DanielCreeklear/HEXPOD/README.md

# HEXPOD
Trabalho de Conclusão de Curso - Técnico em Mecatrônica - 1° Semestre, 2019.
ETEC Martin Luther King - Orientador: Professor Mestre Engenheiro Paulo Roberto Murguer Nogueira


> Status do Projeto: Concluido :heavy_check_mark:

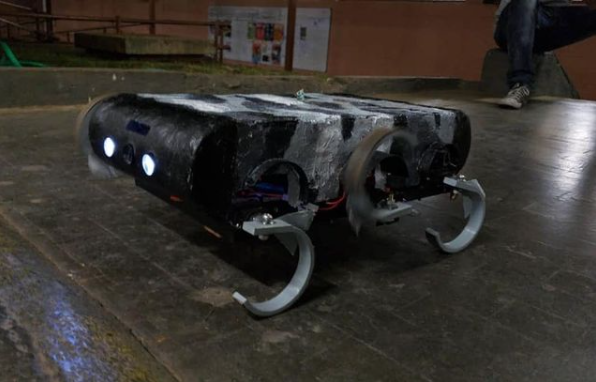
[picture p1: HEXPOD.png]
Foto do HEXPOD no seu ultimo dia de teste!


```C++ 
Serial.print("ESTOU VIVO!");
``` 
:laughing:
## Grupo
|[ <br> <sub> Allan Del Valle </sub>](https://www.linkedin.com/in/allan-del-valle-1b8012140/)|[ <br> <sub> Daniel Lopes </sub>](https://github.com/DanielCreeklear)|[ <br> <sub> Enrique Emanuel Rezende </sub>](https://github.com/Oiapokxui)|[ <br> <sub> Gabriel Luís Frutuoso </sub>](https://www.instagram.com/the_fruit_maker/) 	|
|:-:	|:-:	|:-:	|:-:	|
## Resumo
  Inspirado em um dos [robôs](https://www.youtube.com/watch?v=ISznqY3kESI) criados pela Boston Dynamics, o projeto se resume a um robô hexápode cujo propósito é ser remotamente controlado, útil em ambientes que inviabilizam o uso das rodas. Surge da necessidade de um robô que percorresse a maioria dos terrenos sem muitas dificuldades. Para isso, constitui-se de seis patas com o formato ‘C’, que garante uma boa mobilidade. Com controle por rádio frequência, também inclui uma câmera sem fio, que permite monitoramento a distância e auxilia o controle dos movimentos executados pelo  robô.
## Equipamentos do robô :checkered_flag:

:trophy: Câmera FPV por radio frequência 

:trophy: Controle com 4 botões e 1 analógico via Rádio Frequência

:trophy: Sensor Ultrassônico para navegação autônoma
## Linguagens e bibliotecas utilizadas :books:

- [C/C++ (Arduino)](https://www.arduino.cc/)
- VirtualWire 1.27
## Diagramas e desenhos :page_with_curl:
