DanielCreeklear/HEXPOD/DiagramaMotor.png

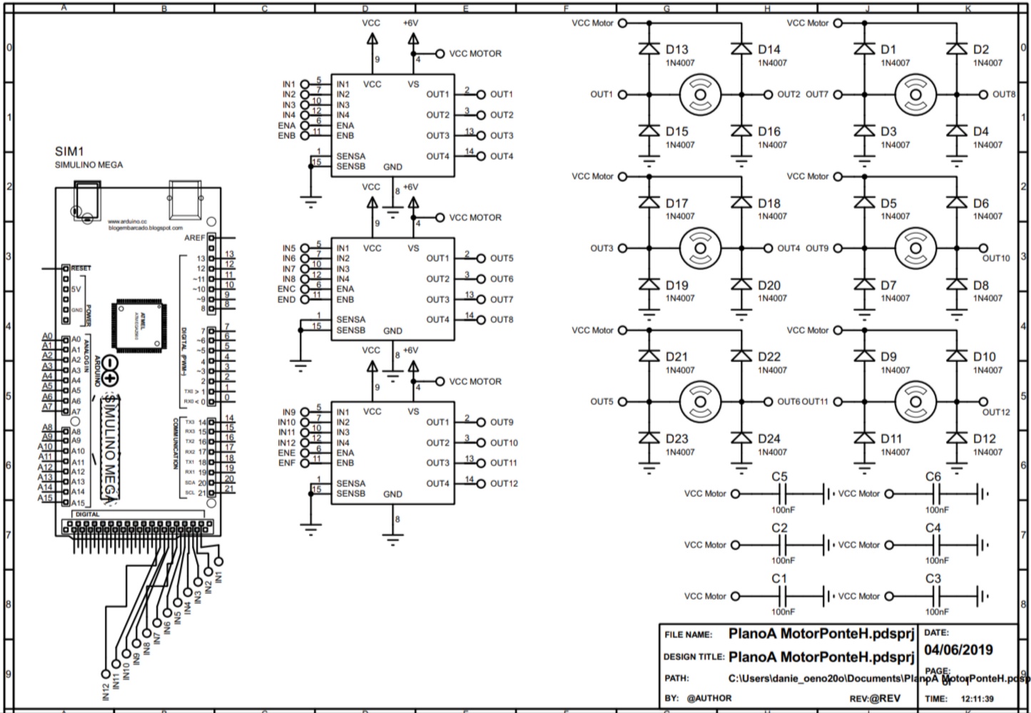
DiagramaMotor.png
