DanielCreeklear/HEXPOD/Mapeamento controle.jpg

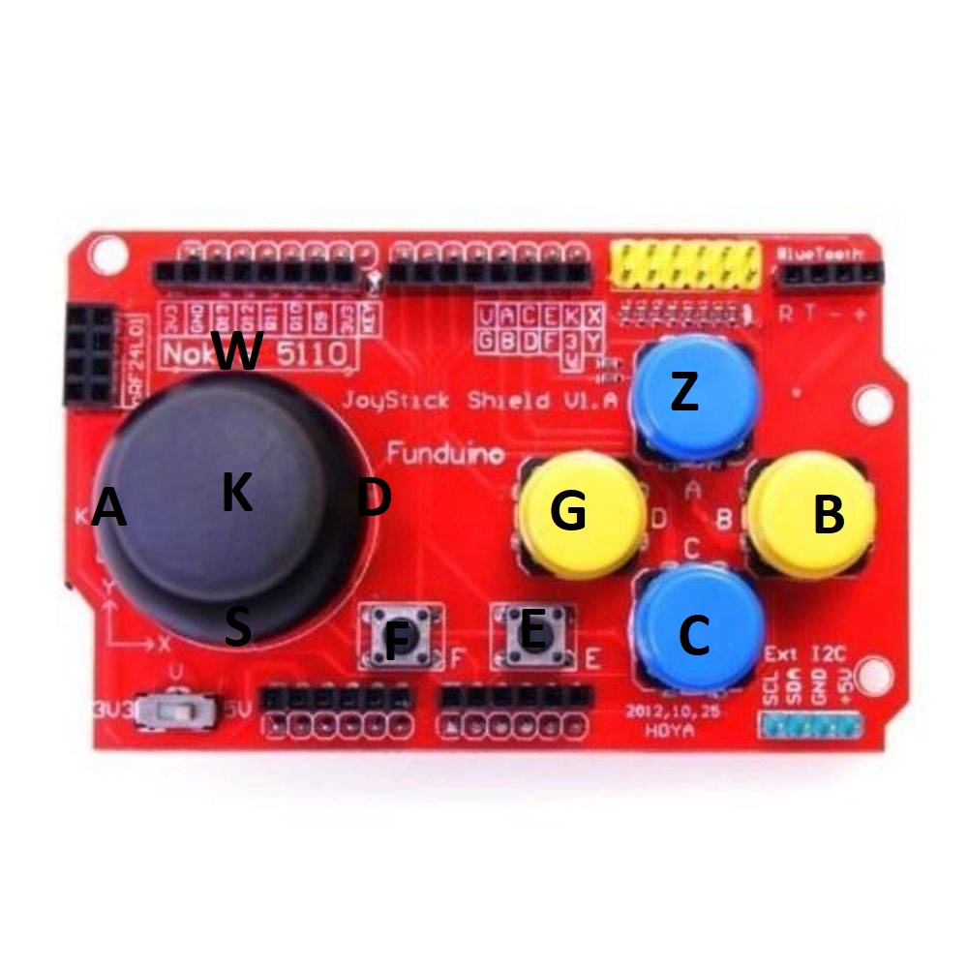
Mapeamento controle.jpg
