DanielCreeklear/HEXPOD/DT-Chassi-REFEITO v1.pdf

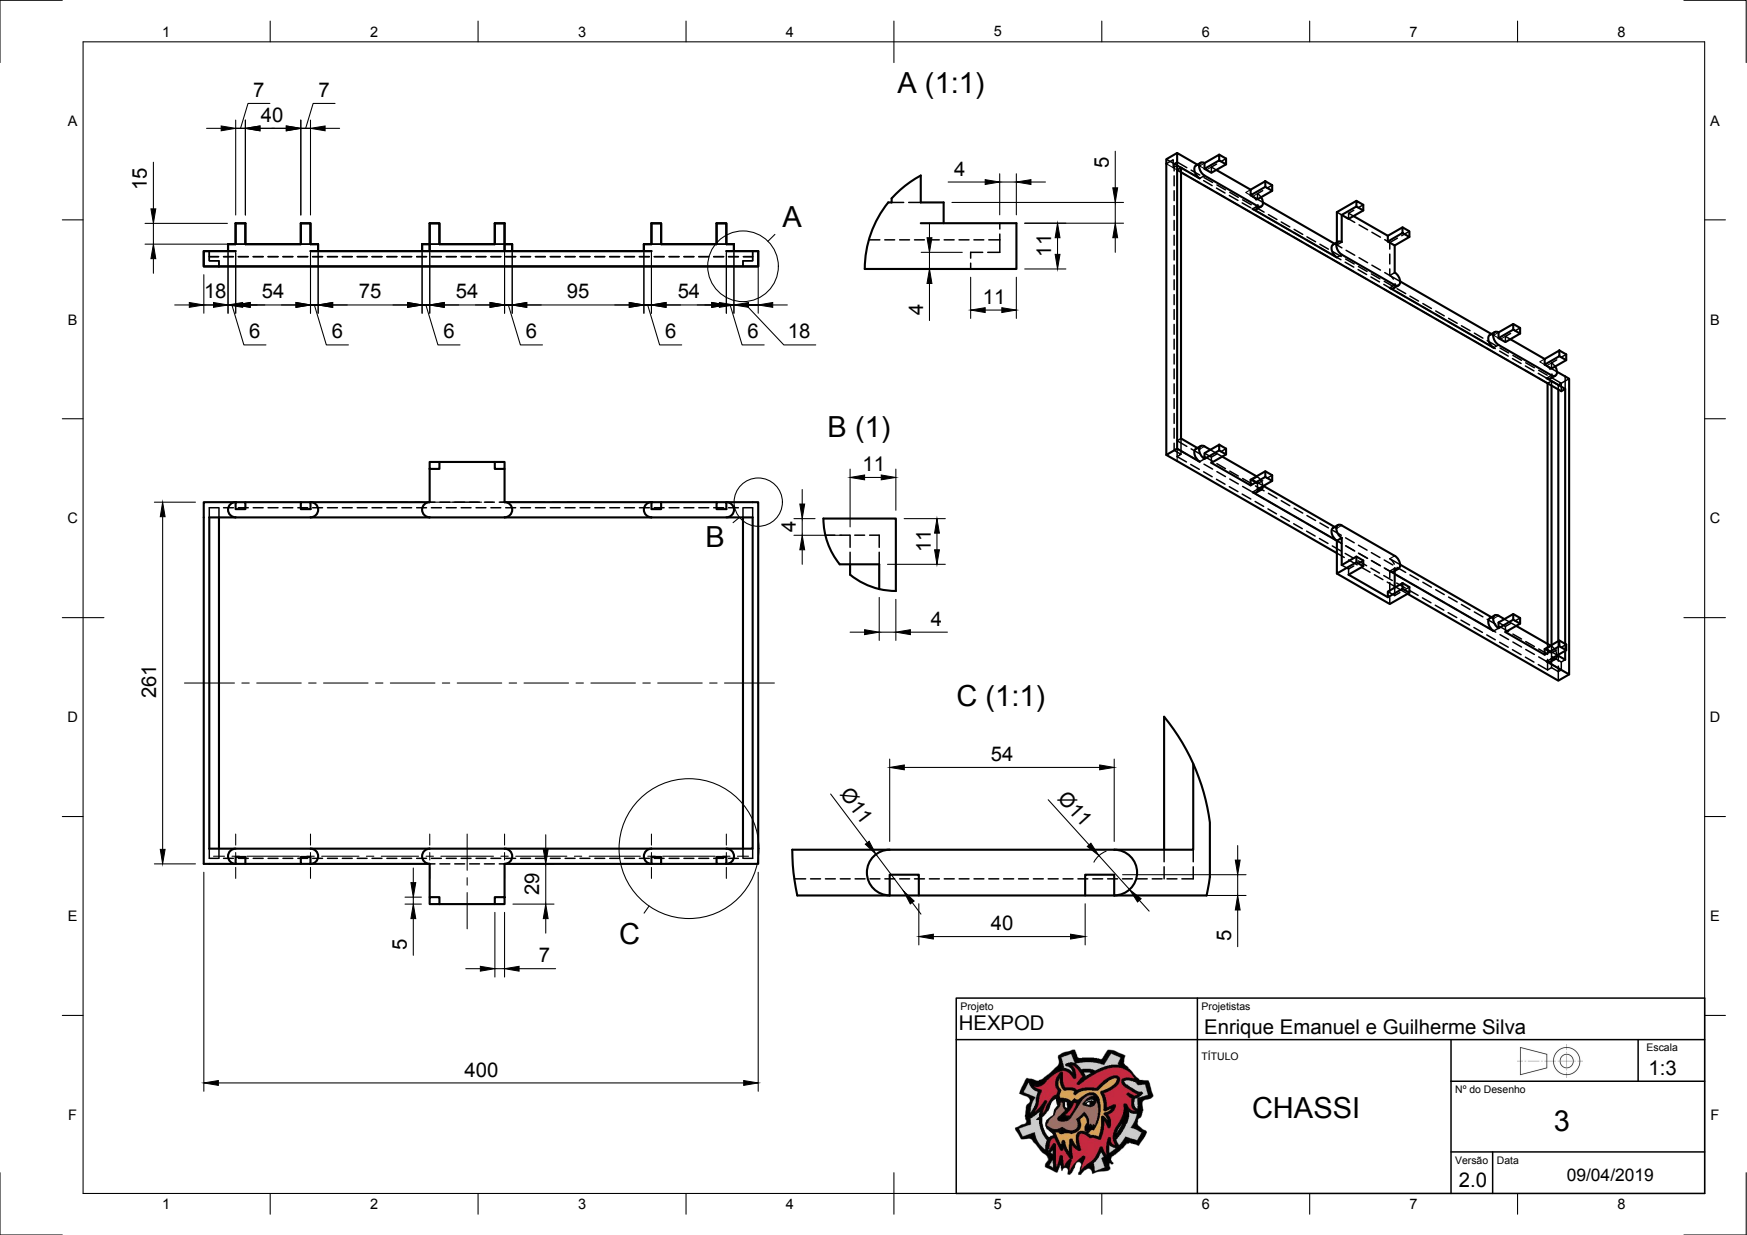
[picture p4: page 1]
Escala TÍTULO

Enrique Emanuel e Guilherme Silva

Nº do Desenho
