DanielCreeklear/HEXPOD/DTPATAS-FALTA_REVISAR.pdf

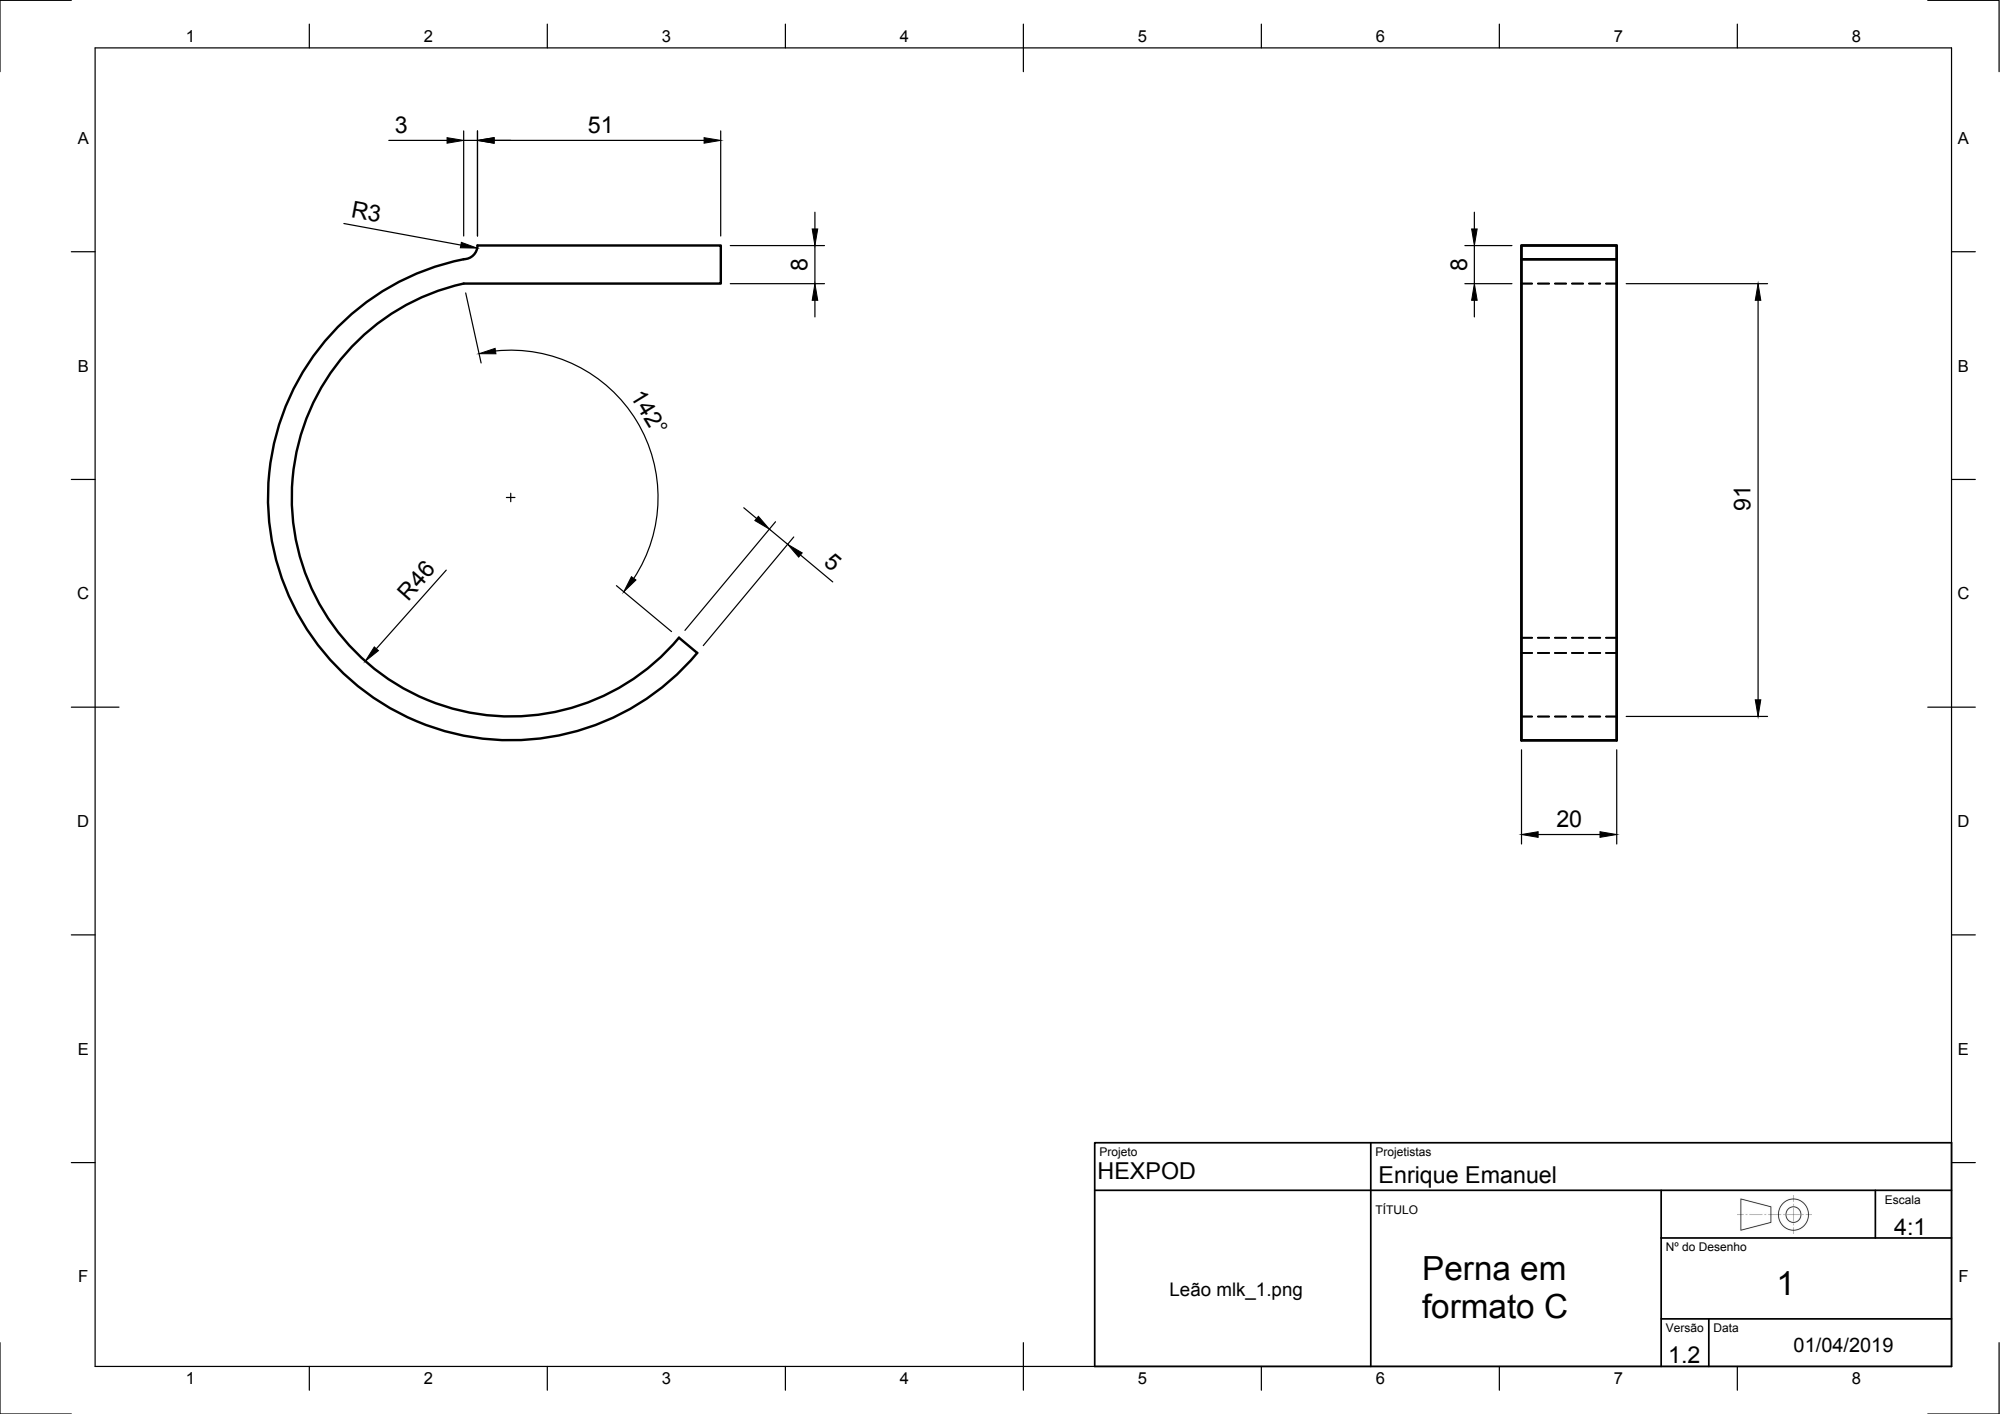
[picture p5: page 1]
Escala TÍTULO

Projeto HEXPOD | Projetistas Enrique Emanuel

Leão mlk_1.png | Perna em formato C | 4:1

Nº do Desenho
