DanielCreeklear/HEXPOD/DTACOPLADOR.pdf

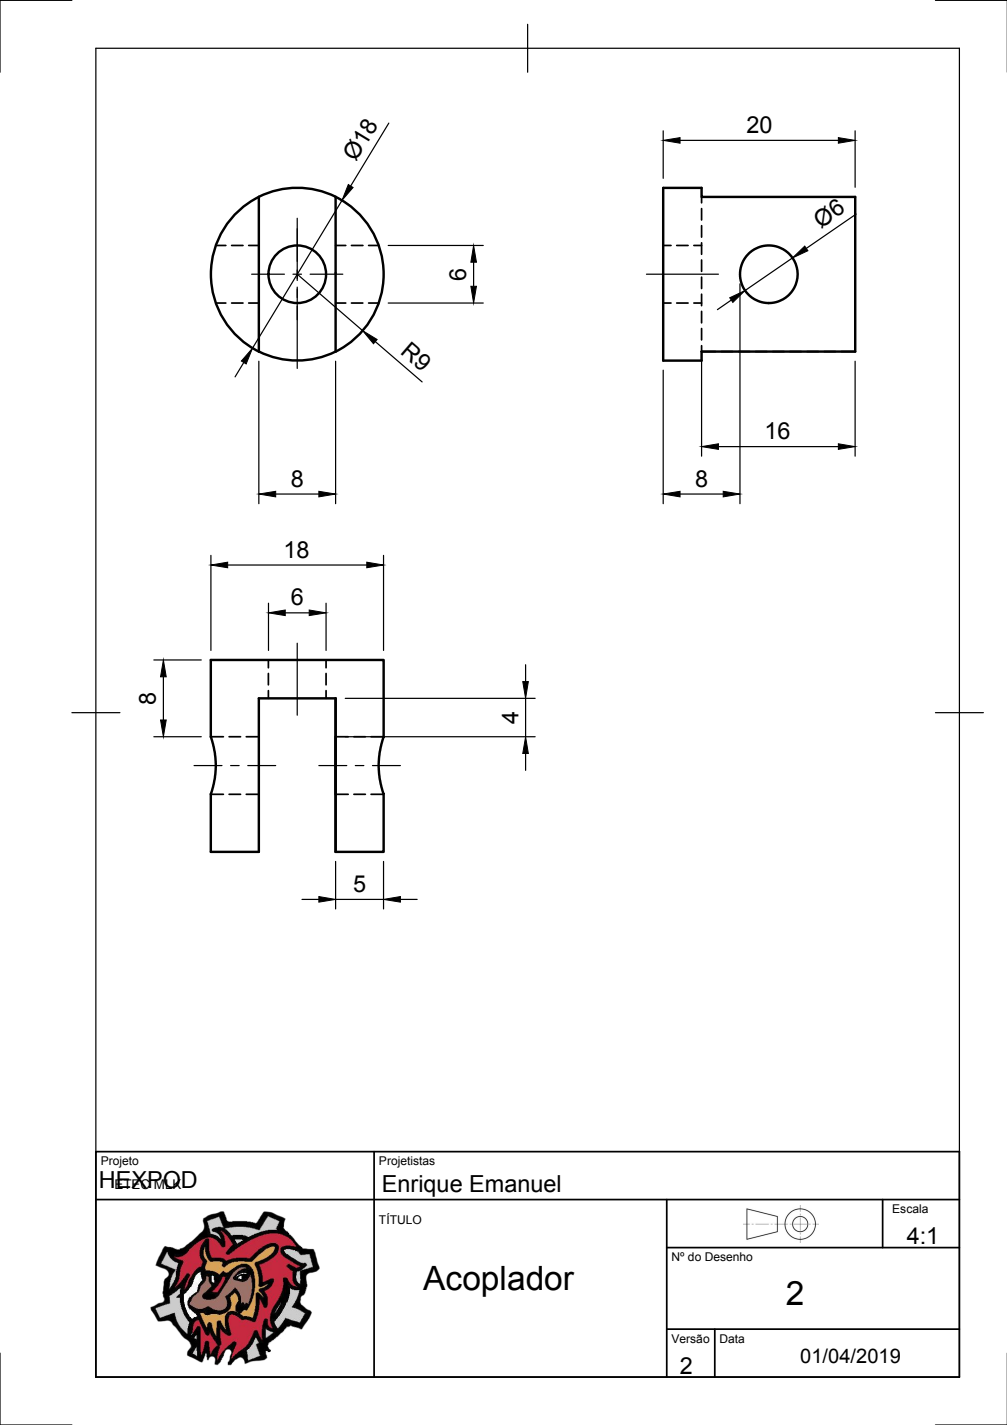
[picture p6: page 1]
ETEC MLK; Escala TÍTULO; Enrique Emanuel

Nº do Desenho
