DanielCreeklear/HEXPOD/(commit log)

2021-01-20 Criado um README para o repositório
2021-01-20 Criado main.ino para usar no robô
2021-01-20 Primeira versão do código
    Em 2021 estou reorganizando meu repositório que utilizei para o meu TCC, aqui estão as primeiras linhas digitadas quando o projeto se iniciou
2021-01-20 Adicionado funções para o movimento dos motores
    Esta alteração foi feita em 2019.
2021-01-20 Função para sincronizar patas
2021-01-20 Alteração na leitura dos sensores
2021-01-20 Retirado prints no console
2021-01-21 Adicionado mais tipos de movimentos
2021-01-21 Atualização para testar a estabilidade do robô parado
2021-01-21 Alterações para sincronização das patas
2021-01-21 Correções nos motores
2021-01-21 Alteração para Ponte-H
2021-01-21 Adicionado sensor Ultrassônico
2021-01-21 Adicionado lógica para controle das patas
2021-01-21 Diagrama dos motores
2021-01-22 Alteração para RF
